Malte-D/esphome-window-actuator/static/index.md

# About

ESPHome Window Actuator motorises an ordinary tilt-and-turn window with two 3D-printed units,
two 12 V servos (DSSERVO DS51150) and an ESP8266. In Home Assistant the window appears as a `cover` that tilts
the window open and closes it again, including turning the handle.

Animation of the window actuator

Parts list, printed parts and the assembly guide are in the
[GitHub repository](https://github.com/Malte-D/esphome-window-actuator).

# Installation

Connect the Wemos D1 mini via USB and click the button below to install the pre-built firmware
directly from the browser (Chrome or Edge). After flashing, enter your Wi-Fi credentials; Home
Assistant will then discover the device. Calibrate the servo positions as described in the
[README](https://github.com/Malte-D/esphome-window-actuator#calibration).

<esp-web-install-button manifest="./manifest.json"></esp-web-install-button>

<script type="module" src="https://unpkg.com/esp-web-tools@9/dist/web/install-button.js?module"></script>
