Malte-D/esphome-window-actuator/parts.md

## Screws ##
- 3x M4x16 countersunk (Base)
- 4x M3x25 (Servo Base)
- 4x M3x10 countersunk (Servohorns)
- 1x M3x10 (PCB)
- 1x M4x16 (Top window mount)
- 1x M6x25 (Arm pivot)

## Hardware ##
- O-Ring 10x2mm (10mm ID)
- 2x Uniball joint M6 (POSA6 or SA6T)
