Malte-D/esphome-window-actuator/print-files/Accessories/CableDuctCorner.step

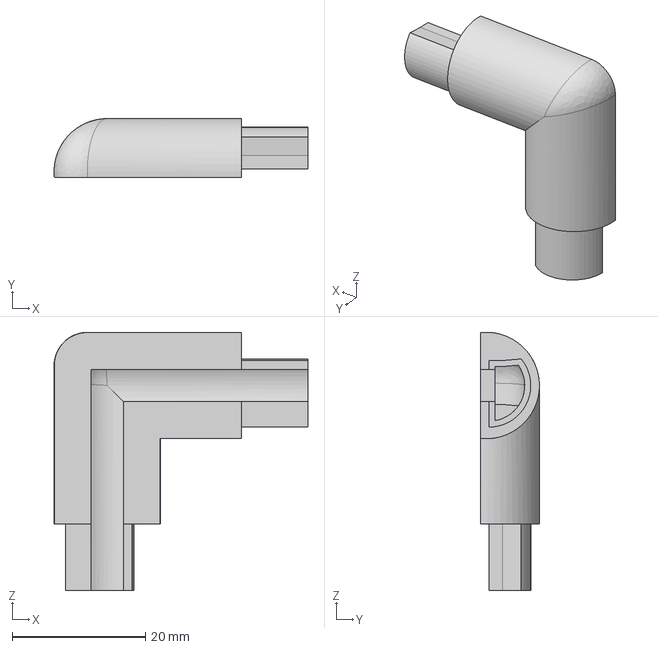
[picture p4: CAD file, 2026-11-08]
print-files/Accessories/CableDuctCorner.step
38.2 x 8.84 x 38.8 mm
