Malte-D/esphome-window-actuator/print-files/Handle/ServoCover.step

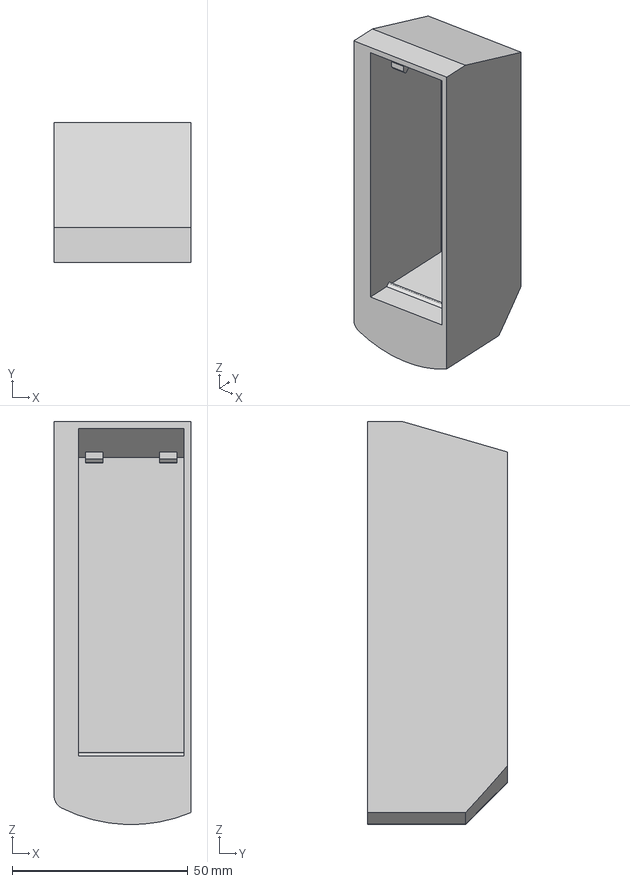
[picture p5: CAD file, 2026-11-07]
print-files/Handle/ServoCover.step
39.0 x 40.0 x 114.8 mm
