Malte-D/esphome-window-actuator/print-files/Movement/BayonetSocket.step

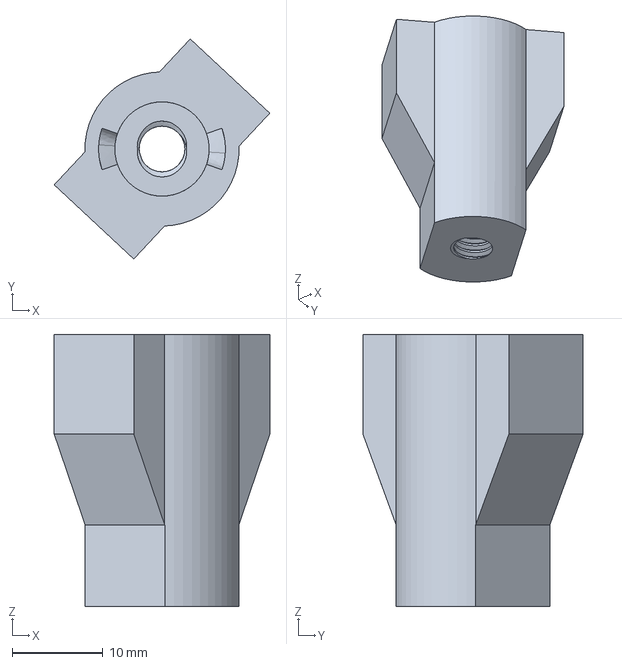
[picture p6: CAD file, 2026-11-08]
print-files/Movement/BayonetSocket.step
23.8 x 24.3 x 30.0 mm
