Malte-D/esphome-window-actuator/print-files/Handle/Base.step

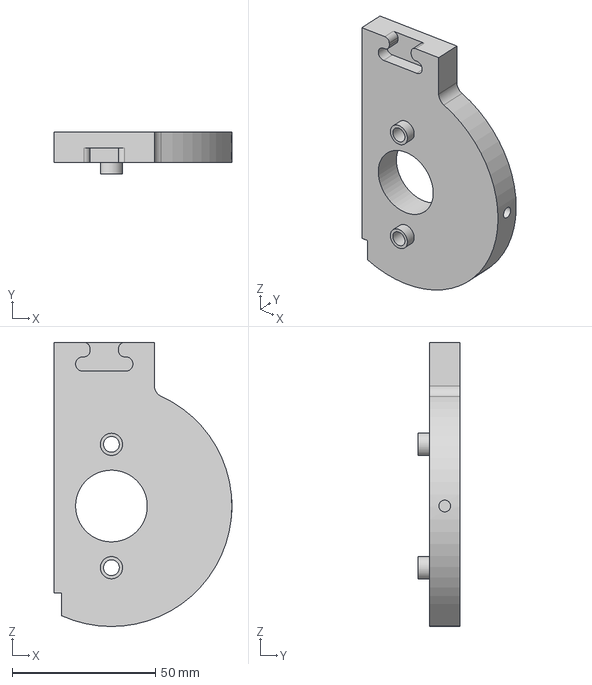
[picture p7: CAD file, 2026-11-07]
print-files/Handle/Base.step
62.0 x 14.6 x 99.0 mm
