Malte-D/esphome-window-actuator/print-files/Movement/BayonetPlug.step

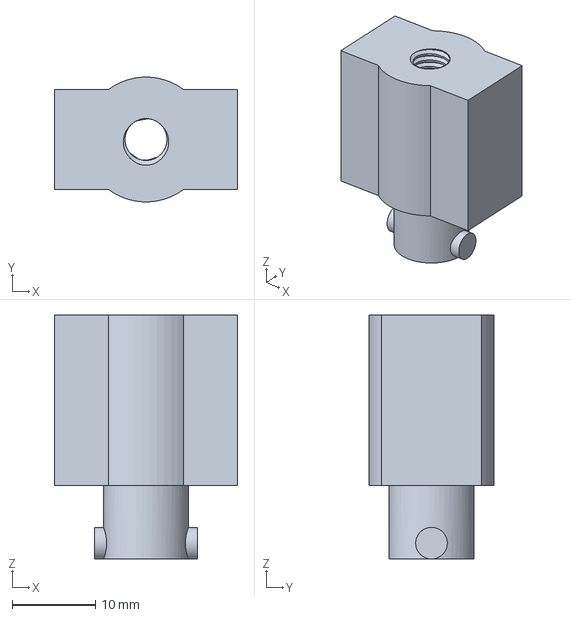
[picture p8: CAD file, 2026-11-08]
print-files/Movement/BayonetPlug.step
22.0 x 15.0 x 29.3 mm
