Malte-D/esphome-window-actuator/print-files/Handle/PCB_Holder.step

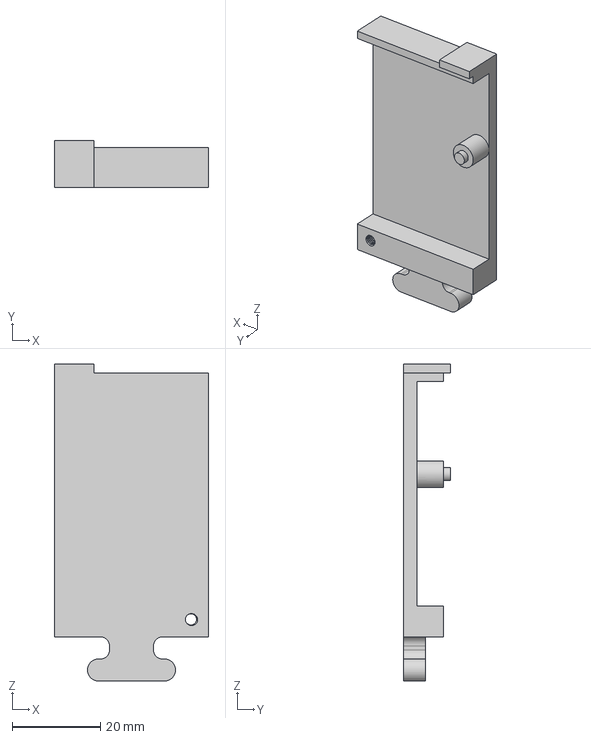
[picture p9: CAD file, 2026-11-07]
print-files/Handle/PCB_Holder.step
35.0 x 10.6 x 72.0 mm
