Malte-D/esphome-window-actuator/print-files/Movement/TopPivotMount2.3mf

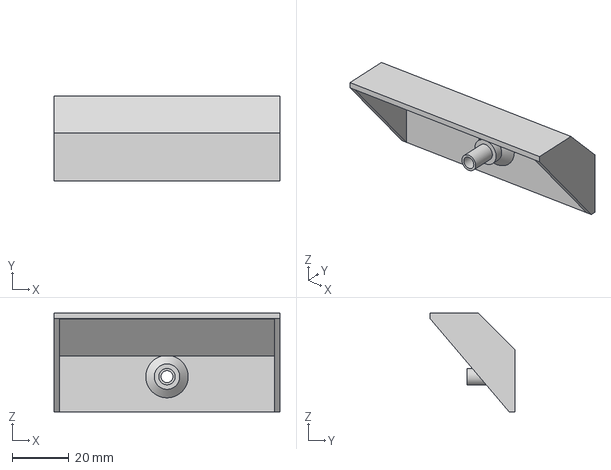
[picture p10: CAD file, 2025-03-17]
print-files/Movement/TopPivotMount2.3mf
80.0 x 30.0 x 35.0 mm
