Malte-D/esphome-window-actuator/print-files/Handle/Case.step

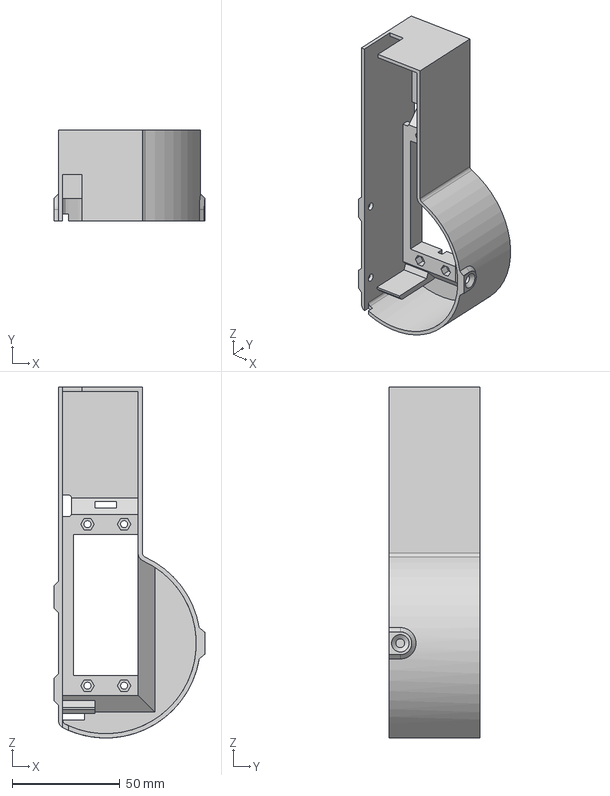
[picture p11: CAD file, 2026-11-07]
print-files/Handle/Case.step
70.0 x 42.4 x 163.0 mm
