Malte-D/esphome-window-actuator/print-files/Movement/ServoArm.step

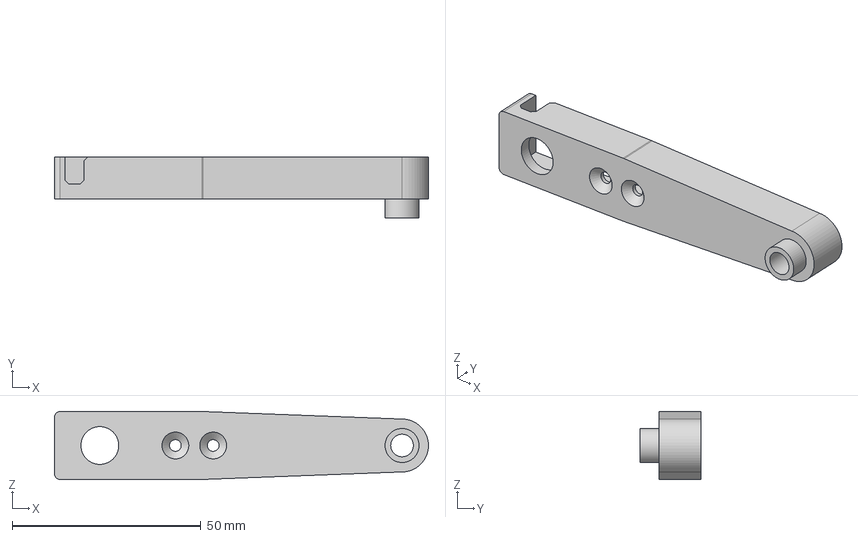
[picture p12: CAD file, 2025-03-17]
print-files/Movement/ServoArm.step
99.0 x 16.2 x 18.0 mm
