Malte-D/esphome-window-actuator/print-files/Handle/ServoHornAdapter.step

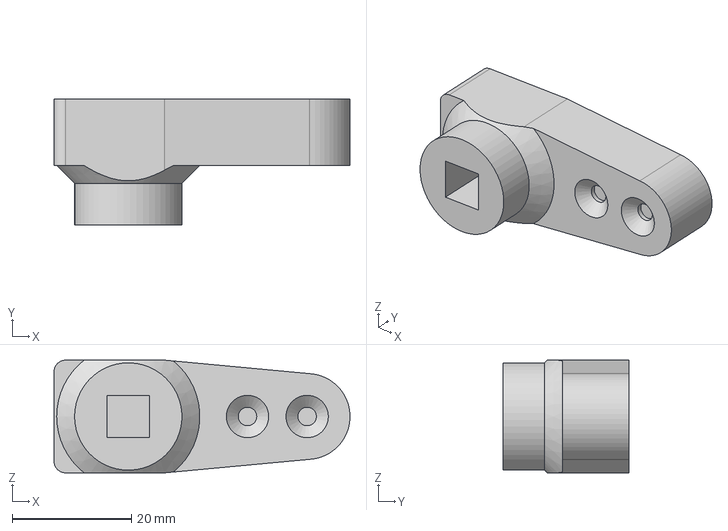
[picture p13: CAD file, 2025-11-30]
print-files/Handle/ServoHornAdapter.step
49.6 x 21.2 x 18.9 mm
