Malte-D/esphome-window-actuator/print-files/Movement/TopPivotMount.step

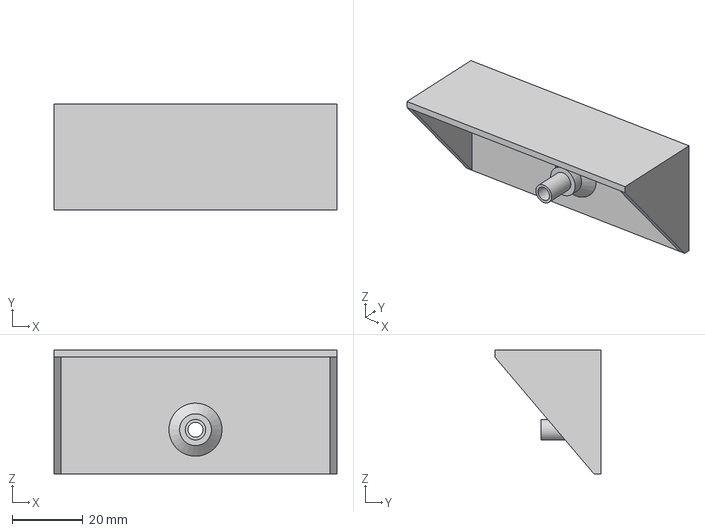
[picture p14: CAD file, 2025-03-17]
print-files/Movement/TopPivotMount.step
80.0 x 30.0 x 35.0 mm
