Malte-D/esphome-window-actuator/print-files/Handle/CoverSnap.step

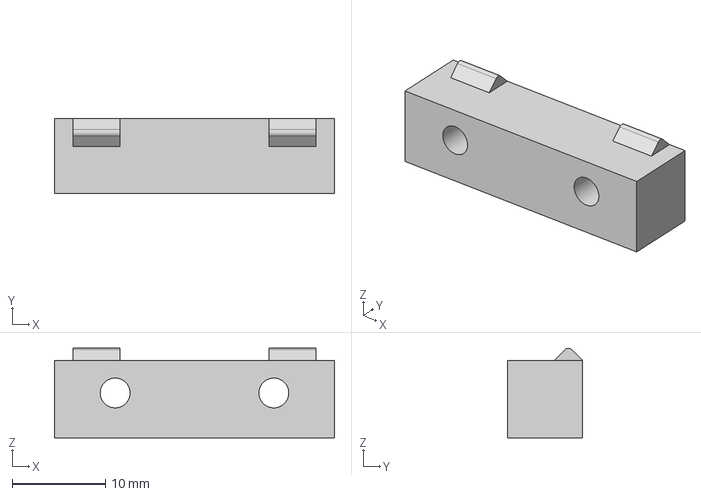
[picture p15: CAD file, 2025-03-17]
print-files/Handle/CoverSnap.step
30.0 x 8.00 x 9.59 mm
