Malte-D/esphome-window-actuator/print-files/Movement/NutHolder.step

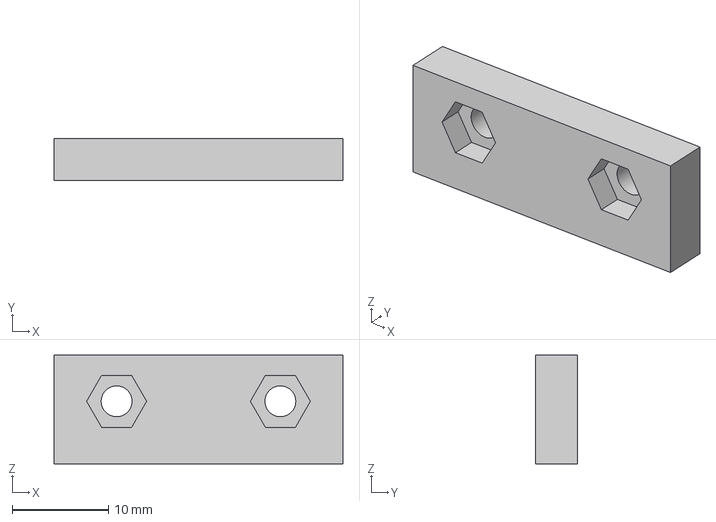
[picture p16: CAD file, 2025-03-17]
print-files/Movement/NutHolder.step
30.0 x 4.40 x 11.3 mm
