Malte-D/esphome-window-actuator/print-files/Movement/ServoCoverMount.step

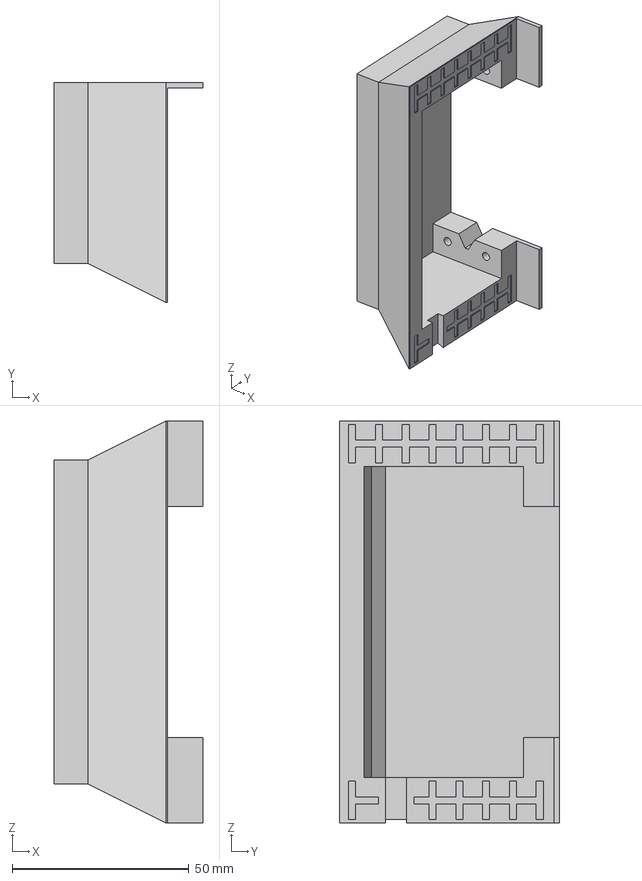
[picture p17: CAD file, 2025-03-17]
print-files/Movement/ServoCoverMount.step
42.0 x 62.2 x 113.6 mm
