Malte-D/esphome-window-actuator/(list of files, cad)

Other CAD files:
print-files/Movement/TopPivotMountChamfered.step
print-files/Accessories/CableDuctCorner.3mf
print-files/Handle/Case.3mf
print-files/Handle/CoverSnap.3mf
print-files/Handle/ServoCover.3mf
print-files/Handle/ServoHornAdapter.3mf
print-files/Movement/BayonetPlug.3mf
print-files/Movement/BayonetSocket.3mf
print-files/Movement/NutHolder.3mf
print-files/Movement/ServoArm.3mf
print-files/Movement/ServoCoverMount.3mf
print-files/Movement/TopPivotMount.3mf
