Malte-D/esphome-window-actuator/pcb/window-opener.brd

## EAGLE design pcb/window-opener.brd (2026-11-08)

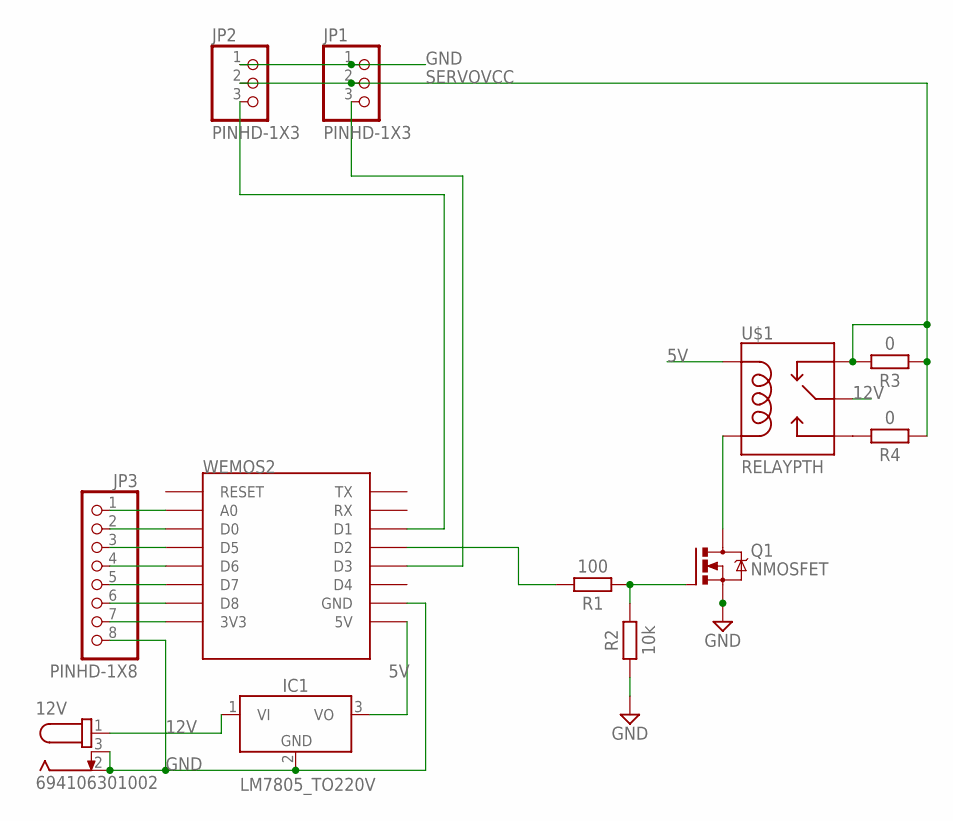
[picture p24: schematic window-opener.sch]

Parts:
12V: 694106301002
IC1: LM7805_TO220V; TO220V
JP1, JP2: PINHD-1X3; 1X03
JP3: PINHD-1X8; 1X08
Q1: NMOSFET; SOT23
R1: 100; RESC2012X65
R2: 10k; RESC2012X65
R3, R4: 0; RESC2012X65
U$1: RELAYPTH; SRD-05VDC-SL-C
WEMOS2: WEMOS-D1-MINI

Connections:
5V: IC1.3 (VO), U$1.COIL1, WEMOS2.5V
12V: 12V.1, IC1.1 (VI), U$1.SWCOMMON
GND: 12V.2, 12V.3, IC1.2 (GND), JP1.1, JP2.1, JP3.8, Q1.2 (S), R2.1, WEMOS2.GND
unnamed: Q1.1 (G), R1.1, R2.2
unnamed: JP2.3, WEMOS2.D1
unnamed: JP3.1, WEMOS2.A0
unnamed: JP1.3, WEMOS2.D3
unnamed: R1.2, WEMOS2.D2
unnamed: JP3.2, WEMOS2.D0
unnamed: JP3.3, WEMOS2.D5
unnamed: JP3.4, WEMOS2.D6
unnamed: JP3.5, WEMOS2.D7
unnamed: JP3.6, WEMOS2.D8
unnamed: JP3.7, WEMOS2.3V3
unnamed: R4.2, U$1.SWOPEN
R: Q1.3 (D), U$1.COIL0
SERVOVCC: JP1.2, JP2.2, R3.1, R3.2, R4.1, U$1.SWCLOSED (SWCLOSE)

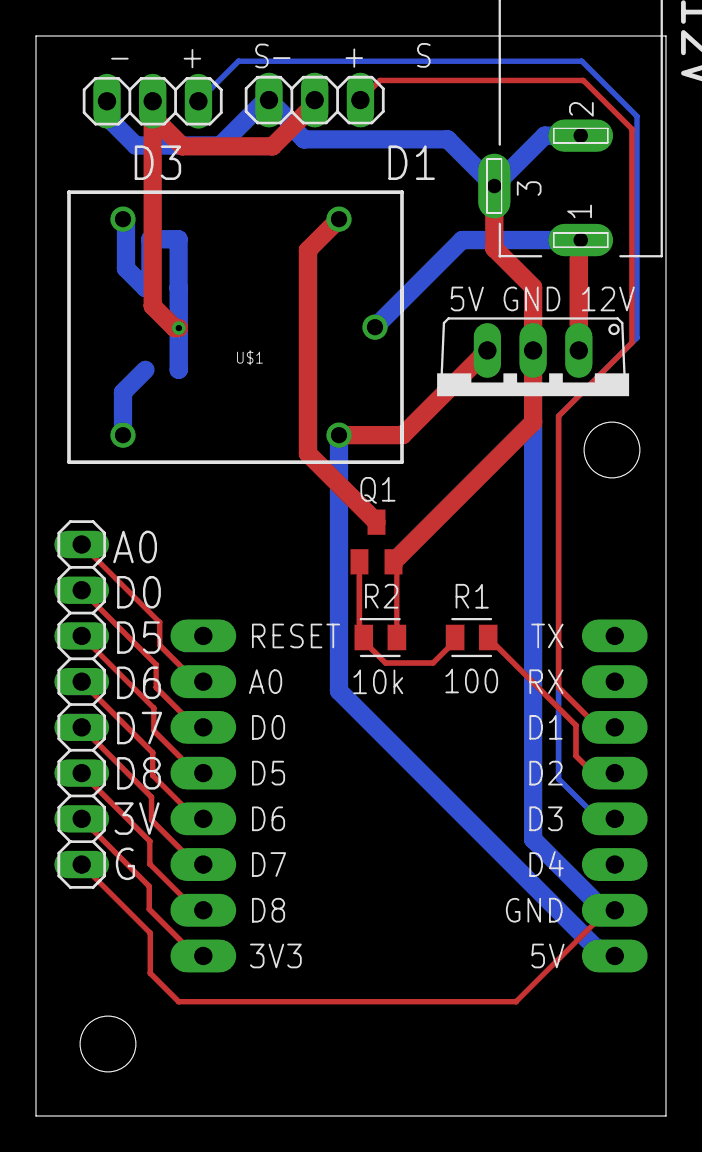
[picture p25: board window-opener.brd from above]

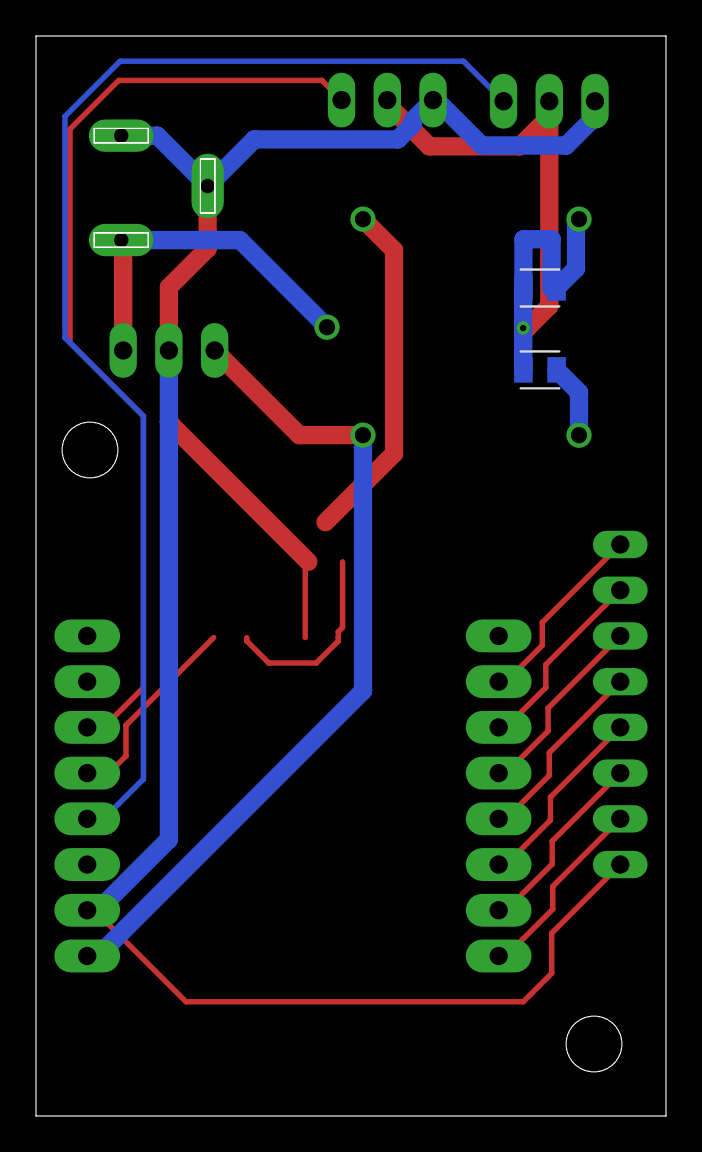
[picture p26: board window-opener.brd from below]

Board: 2 copper layers, 35.0 x 60.0 mm, 12 parts (2 on the bottom side), 17 nets.
