Malte-D/esphome-window-actuator/(commit log)

2025-03-17 added some print files
    [CoverSnap.3mf, CoverSnap.step, NutHolder.3mf, NutHolder.step, ServoArm.3mf, ServoArm.step, ServoCoverMount.3mf, ServoCoverMount.step]
2025-11-30 Updated ServoHornAdapter
    [ServoHornAdapter.3mf, ServoHornAdapter.step]
2026-11-07 Add more print files
2026-11-07 updated case
2026-11-09 Rename project to ESPHome Tilt Window Opener
    The repository is now Malte-D/esphome-tilt-window-opener. Update the
    installer page and repository links, the dashboard import URL and the
    project title. Device and ESPHome project names stay the same so that
    existing devices keep their hostname and entities.
2026-11-09 Fix CI and publish workflows
    The publish workflow called esphome/workflows publish.yml, which ESPHome
    removed in November 2024, so every push failed and the installer page
    kept the firmware from 2024. It now builds the firmware with
    esphome/build-action and deploys it with the installer page to gh-pages
    itself, and runs only when the YAML, the page or the workflow change.
    CI used build-action v6, which no longer works with current ESPHome
    images. Update it to v8.1.0 and allow manual runs.
